GarronAnderson/InsideMyHive-V2/readme.md

# STM32 Beehive Monitor

in active development

thanks to 
https://github.com/Reetabass/STM32-HAL-SX1276-LoRa 
for the LoRa libraries
and
https://github.com/libdriver/htu21d
for the htu21d driver
