GarronAnderson/InsideMyHive-V2/datasheets for PCB/st-link pinout.png

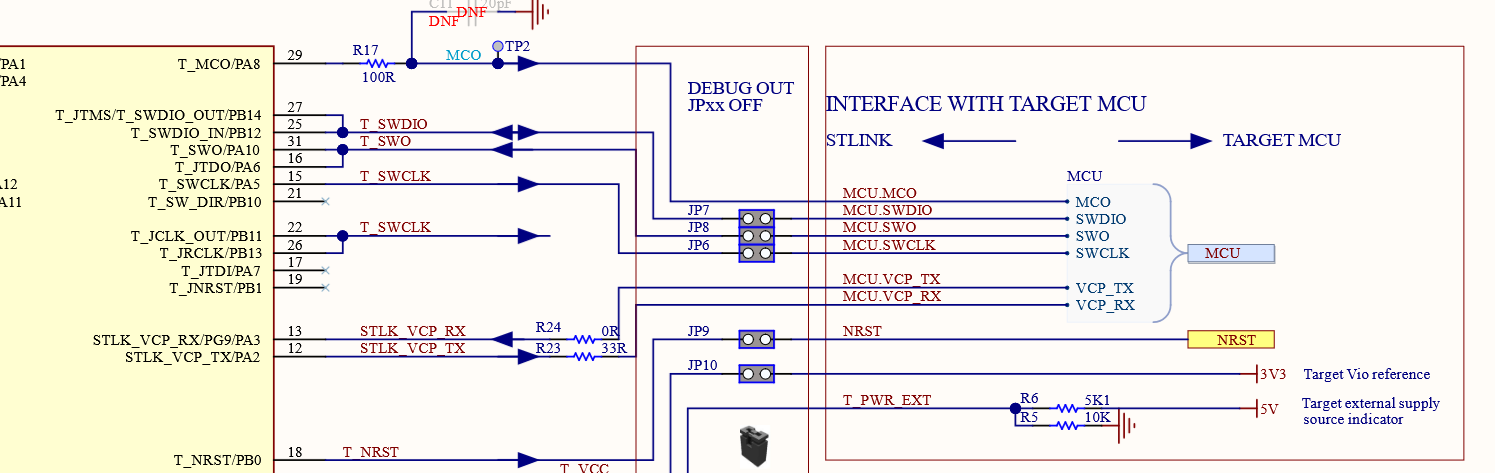
datasheets for PCB/st-link pinout.png
