GarronAnderson/InsideMyHive-V2/monitor pcb/monitor pcb.csv

# | Reference | Qty | Value | Footprint | DNP
1 | AE1 | 1 | Antenna
2 | C1, C2, C3, C5, C7 | 5 | 100nF | Capacitor_SMD:C_0603_1608Metric
3 | C4 | 1 | 10uF | Capacitor_SMD:C_0805_2012Metric
4 | C6 | 1 | 1uF | Capacitor_SMD:C_0603_1608Metric
5 | C8, C9 | 2 | 8.2, 10, 12 pF | Capacitor_SMD:C_0603_1608Metric
6 | C10, C11 | 2 | 1uF
7 | C12, C14, C15 | 3 | 0.1uF
8 | C13 | 1 | 330pF
9 | C16, C19, C20, C21, C23, C25, C26 | 7 | 100nF
10 | C17 | 1 | 22uF
11 | C18, C22, C24 | 3 | 10uF
12 | FB1 | 1 | FerriteBead_Small
13 | J1 | 1 | Conn_02x03_Counter_Clockwise
14 | J2 | 1 | TO LOAD CELL
15 | J3 | 1 | Tipping Bucket Rain Gauge
16 | J4 | 1 | on weather head
17 | J5 | 1 | from weather head
18 | J6 | 1 | in hive sensor
19 | J7 | 1 | from hive sensor
20 | J8 | 1 | 1S LiFePO4 (protected)
21 | J9 | 1 | pin header to TFT
22 | L1 | 1 | 2.2uH
23 | Q1 | 1 | DMP3125L-7
24 | R1, R2 | 2 | 47
25 | R3 | 1 | 36.5K
26 | R4 | 1 | 10k
27 | R5 | 1 | 100k
28 | R6, R7 | 2 | 4.7k
29 | R8, R9, R10, R11 | 4 | 33
30 | R13 | 1 | 470k
31 | SW1 | 1 | SW_Push
32 | U1 | 1 | STM32U031C8T6 | LQFP48_STM
33 | U2 | 1 | NAU7802SGI | SOI16_NAU7802SGI_NUV
34 | U3 | 1 | ~
35 | U4 | 1 | TPS63900 | Package_SON:WSON-10-1EP_2.5x2.5mm_P0.5mm_EP1.2x2mm_ThermalVias
36 | U5, U6 | 2 | HDC3022DEJR | DEJ0008A-C01-IPC_A
37 | U7 | 1 | BMP581 | QFN10_BMP581_BOS
38 | U8 | 1 | MB85RS1MT | Package_SO:SOIC-8_3.9x4.9mm_P1.27mm
39 | U9 | 1 | TPS22919DCKR | DCK0006A_N
40 | U10, U11 | 2 | TPD2E2U06DCKR | DCK0003A-IPC_A
41 | Y1 | 1 | Crystal | Crystal:Crystal_SMD_2012-2Pin_2.0x1.2mm
