GarronAnderson/InsideMyHive-V2/in hive sensor pcb/in_hive_sensor.kicad_pcb

## KiCad design in hive sensor pcb/in_hive_sensor.kicad_pcb (2026-10-23)

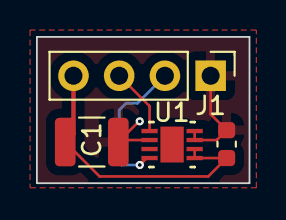
[picture p2: board in_hive_sensor.kicad_pcb from above]

Board: 2 copper layers, 11.8 x 8.1 mm, 4 parts (0 on the bottom side), 4 nets.

Parts:
C1: 10uF; C_1210_3225Metric
C2: 100nF; C_0603_1608Metric
J1: in hive sensor; PinHeader_1x04_P2.54mm_Vertical
U1: HDC3022DEJR; DEJ0008A-C01-IPC_A

Connections:
+3V3: C1.1, C2.2, J1.4, U1.5 (VDD), U1.6 (RESET_N)
GND: C1.2, C2.1, J1.1, U1.2 (ADDR), U1.7 (ADDR1), U1.8 (GND)
SCL: J1.2, U1.4 (SCL)
SDA: J1.3, U1.1 (SDA)
