GarronAnderson/InsideMyHive-V2/weather head pcb/weather_head.kicad_pcb

## KiCad design weather head pcb/weather_head.kicad_pcb (2026-10-23)

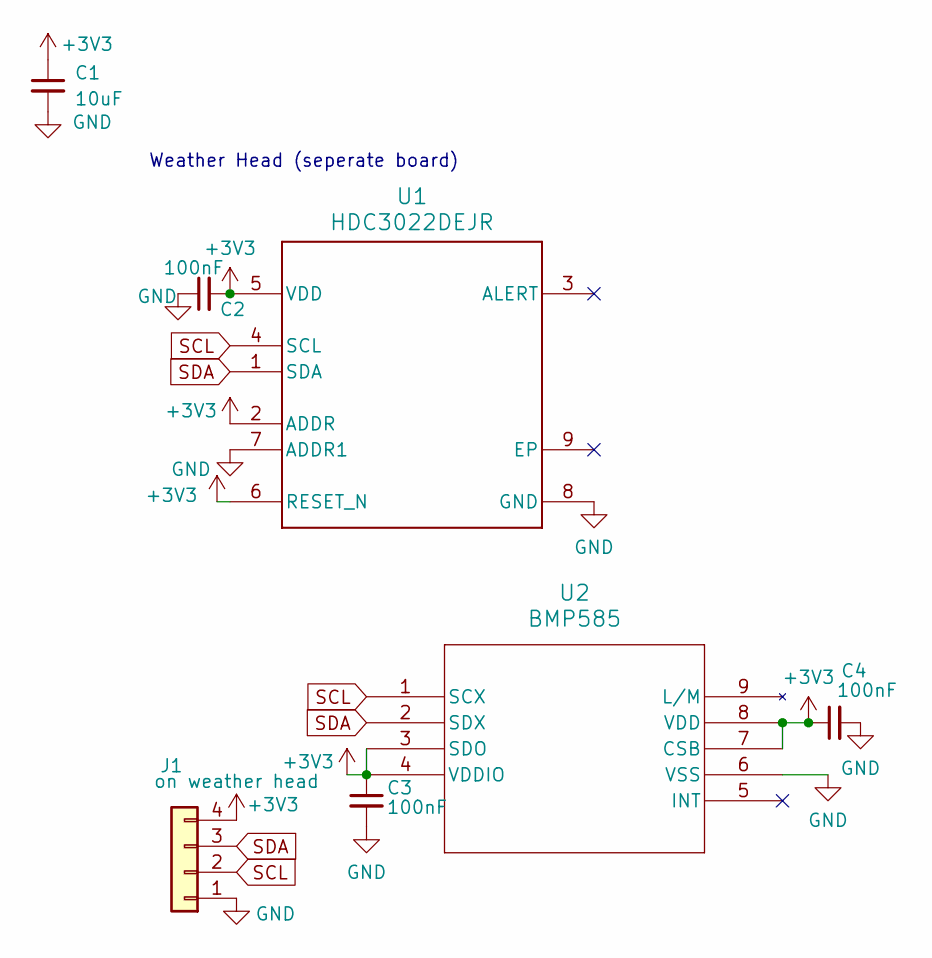
[picture p3: schematic weather_head.kicad_sch]

Parts:
C1: 10uF; C_1210_3225Metric
C2, C3, C4: 100nF; C_0603_1608Metric
J1: on weather head; PinHeader_1x04_P2.54mm_Vertical
U1: HDC3022DEJR; DEJ0008A-C01-IPC_A
U2: BMP585; LGA9_BMP585_BOS

Connections:
+3V3: C1.1, C2.2, C3.1, C4.1, J1.4, U1.2 (ADDR), U1.5 (VDD), U1.6 (RESET_N), U2.3 (SDO), U2.4 (VDDIO), U2.7 (CSB), U2.8 (VDD)
GND: C1.2, C2.1, C3.2, C4.2, J1.1, U1.7 (ADDR1), U1.8 (GND), U2.6 (VSS)
SCL: J1.2, U1.4 (SCL), U2.1 (SCX)
SDA: J1.3, U1.1 (SDA), U2.2 (SDX)

Notes on the sheet:
Weather Head (seperate board)

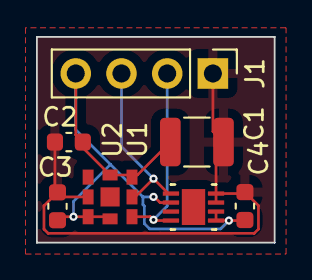
[picture p4: board weather_head.kicad_pcb from above]

Board: 2 copper layers, 13.2 x 11.4 mm, 7 parts (0 on the bottom side), 4 nets.
