GarronAnderson/InsideMyHive-V2/monitor pcb/monitor pcb.kicad_pcb

## KiCad design monitor pcb/monitor pcb.kicad_pcb (2026-10-23)

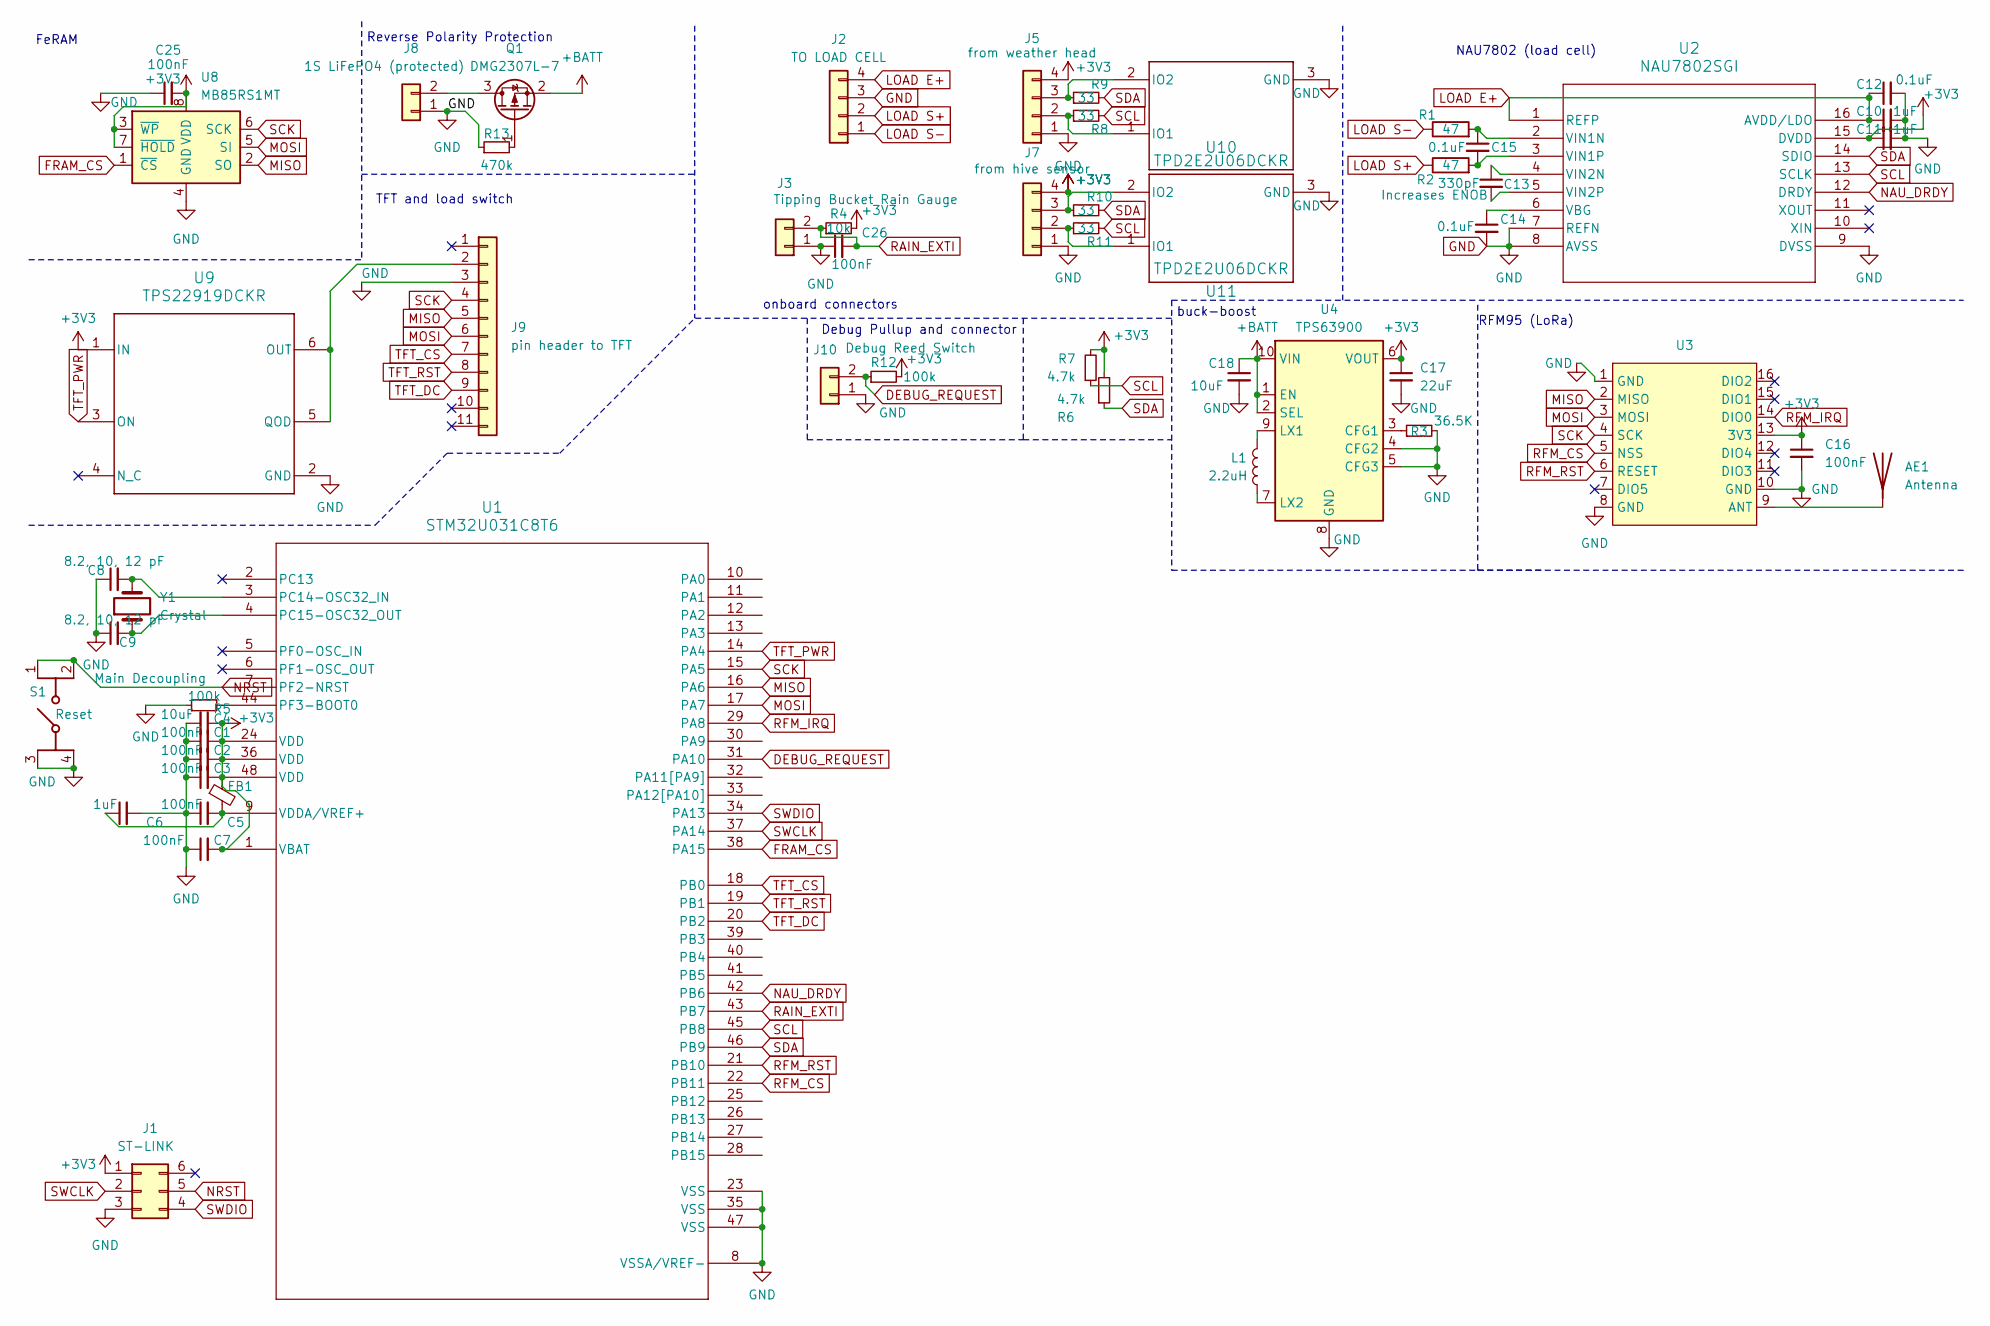
[picture p5: schematic monitor pcb.kicad_sch, Beehive Monitor PCB]

Parts:
AE1: Antenna; SMA_EDGELAUNCH
C1, C2, C3, C5, C7, C16, C25, C26: 100nF; C_0603_1608Metric
C4: 10uF; C_0805_2012Metric
C6: 1uF; C_0603_1608Metric
C8, C9: 8.2, 10, 12 pF; C_0402_1005Metric
C10, C11: 1uF; C_0805_2012Metric
C12, C14, C15: 0.1uF; C_0603_1608Metric
C13: 330pF; C_0402_1005Metric
C17: 22uF; C_1210_3225Metric
C18: 10uF; C_1210_3225Metric
FB1: FerriteBead_Small; L_0603_1608Metric
J1: Conn_02x03_Counter_Clockwise; PinHeader_2x03_P2.54mm_Vertical
J2: TO LOAD CELL; TerminalBlock_Phoenix_PT-1,5-4-3.5-H_1x04_P3.50mm_Horizontal
J3: Tipping Bucket Rain Gauge; TerminalBlock_Phoenix_PT-1,5-2-3.5-H_1x02_P3.50mm_Horizontal
J5: from weather head; TerminalBlock_Phoenix_PT-1,5-4-3.5-H_1x04_P3.50mm_Horizontal
J7: from hive sensor; TerminalBlock_Phoenix_PT-1,5-4-3.5-H_1x04_P3.50mm_Horizontal
J8: 1S LiFePO4 (protected); JST_PH_S2B-PH-K_1x02_P2.00mm_Horizontal
J9: pin header to TFT; PinHeader_1x11_P2.54mm_Vertical
J10: Debug Reed Switch; PinHeader_1x02_P2.54mm_Vertical
L1: 2.2uH; SRN3015TA2R2M
Q1: DMG2307L-7; SOT-23-3
R1, R2: 47; R_0603_1608Metric
R3: 36.5K; R_0603_1608Metric
R4: 10k; R_0603_1608Metric
R5, R12: 100k; R_0603_1608Metric
R6, R7: 4.7k; R_0603_1608Metric
R8, R9, R10, R11: 33; R_0603_1608Metric
R13: 470k; R_0603_1608Metric
S1: PTS647SN38SMTR2_LFS; PTS647SM38SMTR2LFS; Manufacturer_Part_Number PTS647SN38SMTR2 LFS
U1: STM32U031C8T6; LQFP-48_7x7mm_P0.5mm
U2: NAU7802SGI; SOIC-16_3.9x9.9mm_P1.27mm
U3: RFM95W
U4: TPS63900; WSON-10-1EP_2.5x2.5mm_P0.5mm_EP1.2x2mm_ThermalVias
U8: MB85RS1MT; SOIC-8_3.9x4.9mm_P1.27mm
U9: TPS22919DCKR; SOT-363_SC-70-6
U10, U11: TPD2E2U06DCKR; SOT-323_SC-70
Y1: Crystal; Crystal_SMD_2012-2Pin_2.0x1.2mm

Connections:
+3V3: C1.2, C2.2, C3.2, C4.1, C7.2, C11.1, C16.1, C17.1, C25.2, FB1.1, J1.1, J5.4, J7.4, R4.2, R6.2, R7.2, R12.2, U1.1 (VBAT), U1.24 (VDD), U1.36 (VDD), U1.48 (VDD), U2.15 (DVDD), U3.13 (3V3), U4.6 (VOUT), U8.3 (~WP), U8.7 (~HOLD), U8.8 (VDD), U9.1 (IN)
+BATT: C18.1, Q1.2 (S), U4.1 (EN), U4.2 (SEL), U4.10 (VIN)
DEBUG_REQUEST: J10.2, R12.1, U1.31 (PA10)
FRAM_CS: U1.38 (PA15), U8.1 (~CS)
GND: AE1.GND@1, AE1.GND@2, AE1.GND@3, AE1.GND@4, C1.1, C2.1, C3.1, C4.2, C5.1, C6.2, C7.1, C8.1, C9.1, C10.2, C11.2, C12.2, C14.2, C16.2, C17.2, C18.2, C25.1, C26.1, J1.3, J2.3, J3.1, J5.1, J7.1, J8.1, J9.3, J10.1, R3.2, R5.1, R13.1, S1.3 (COM_1), S1.4 (COM_2), U1.8 (VSSA/VREF-), U1.23 (VSS), U1.35 (VSS), U1.47 (VSS), U2.7 (REFN), U2.8 (AVSS), U2.9 (DVSS), U3.1 (GND), U3.8 (GND), U3.10 (GND), U4.4 (CFG2), U4.5 (CFG3), U4.8 (GND), U4.11 (GND), U8.4 (GND), U9.2 (GND), U10.3 (GND), U11.3 (GND)
LOAD E+: C10.1, C12.1, J2.4, U2.1 (REFP), U2.16 (AVDD/LDO)
LOAD S+: J2.2, R2.1
LOAD S-: J2.1, R1.1
MISO: J9.5, U1.16 (PA6), U3.2 (MISO), U8.2 (SO)
MOSI: J9.6, U1.17 (PA7), U3.3 (MOSI), U8.5 (SI)
NAU_DRDY: U1.42 (PB6), U2.12 (DRDY)
NRST: J1.5, S1.1 (NO_1), S1.2 (NO_2), U1.7 (PF2-NRST)
unnamed: AE1.1, AE1.P, U3.9 (ANT)
unnamed: J5.2, R8.1, U10.1 (IO1)
unnamed: J5.3, R9.1, U10.2 (IO2)
unnamed: J7.2, R11.1, U11.1 (IO1)
unnamed: J7.3, R10.1, U11.2 (IO2)
unnamed: J8.2, Q1.3 (D)
unnamed: J9.2, U9.5 (QOD), U9.6 (OUT)
unnamed: Q1.1 (G), R13.2
unnamed: C8.2, U1.3 (PC14-OSC32_IN), Y1.2
unnamed: C9.2, U1.4 (PC15-OSC32_OUT), Y1.1
unnamed: R5.2, U1.44 (PF3-BOOT0)
unnamed: C5.2, C6.1, FB1.2, U1.9 (VDDA/VREF+)
unnamed: C14.1, U2.6 (VBG)
unnamed: C15.1, R1.2, U2.2 (VIN1N)
unnamed: C15.2, R2.2, U2.3 (VIN1P)
unnamed: C13.1, U2.4 (VIN2N)
unnamed: C13.2, U2.5 (VIN2P)
unnamed: R3.1, U4.3 (CFG1)
unnamed: L1.2, U4.9 (LX1)
unnamed: L1.1, U4.7 (LX2)
RAIN_EXTI: C26.2, J3.2, R4.1, U1.43 (PB7)
RFM_CS: U1.22 (PB11), U3.5 (NSS)
RFM_IRQ: U1.29 (PA8), U3.14 (DIO0)
RFM_RST: U1.21 (PB10), U3.6 (RESET)
SCK: J9.4, U1.15 (PA5), U3.4 (SCK), U8.6 (SCK)
SCL: R7.1, R8.2, R11.2, U1.45 (PB8), U2.13 (SCLK)
SDA: R6.1, R9.2, R10.2, U1.46 (PB9), U2.14 (SDIO)
SWCLK: J1.2, U1.37 (PA14)
SWDIO: J1.4, U1.34 (PA13)
TFT_CS: J9.7, U1.18 (PB0)
TFT_DC: J9.9, U1.20 (PB2)
TFT_PWR: U1.14 (PA4), U9.3 (ON)
TFT_RST: J9.8, U1.19 (PB1)

Notes on the sheet:
Debug Pullup and connector
onboard connectors
FeRAM
RFM95 (LoRa)
Reverse Polarity Protection
buck-boost
NAU7802 (load cell)
TFT and load switch

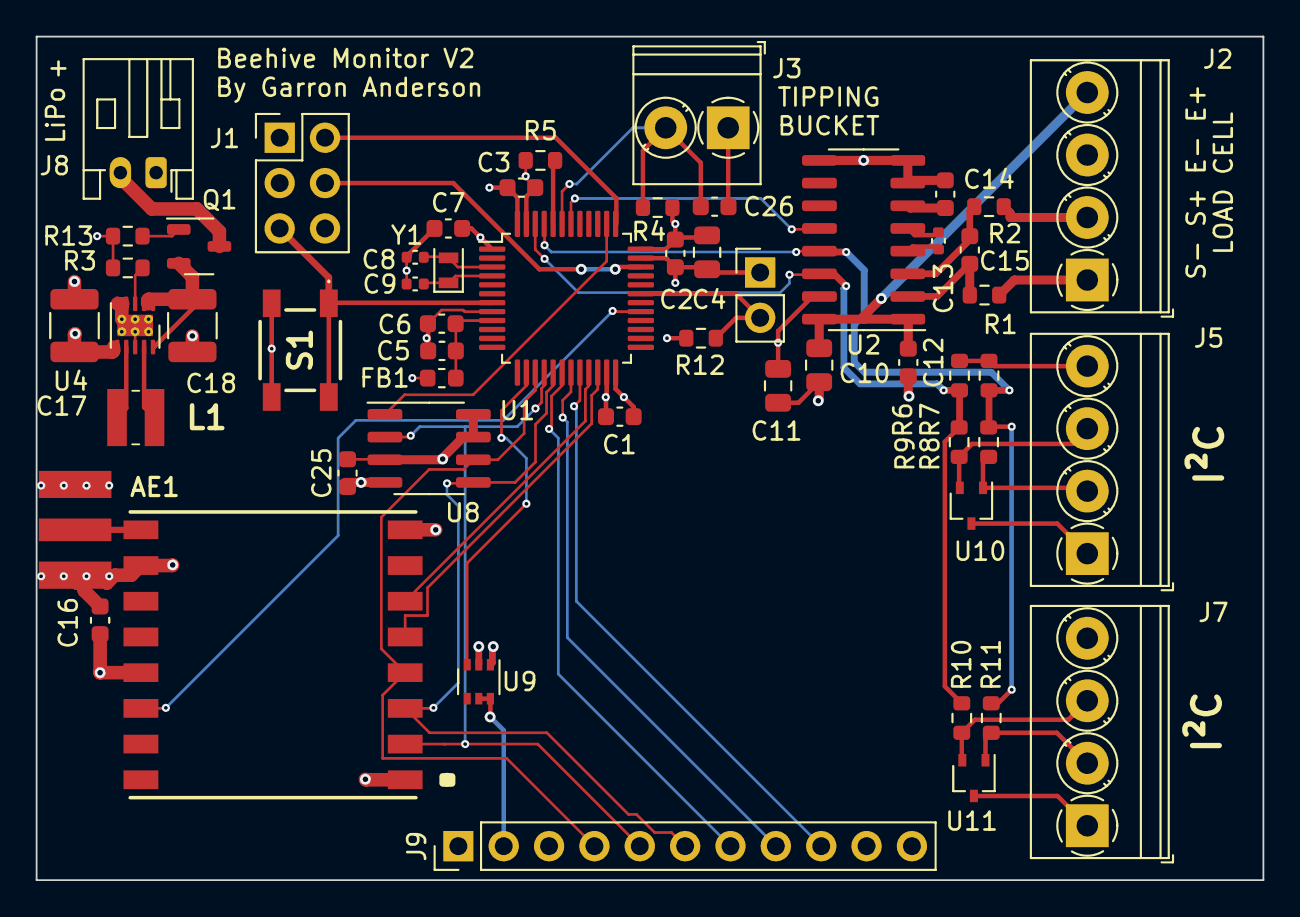
[picture p6: board monitor pcb.kicad_pcb from above]

Board: 4 copper layers, 68.7 x 47.2 mm, 55 parts (0 on the bottom side), 45 nets.
