GarronAnderson/InsideMyHive-V2/pcb version/pcb version.ioc

Mcu.UserName=STM32U031C8Tx
PA10.GPIO_Label=DEBUG_REQUEST
PA10.Signal=GPXTI10
PA15.GPIO_Label=FRAM_CS
PA15.Signal=GPIO_Output
PA4.GPIO_Label=TFT_PWR
PA4.Signal=GPIO_Output
PA5.Signal=SPI1_SCK
PA6.Signal=SPI1_MISO
PA7.Signal=SPI1_MOSI
PA8.GPIO_Label=RFM_IRQ
PA8.Signal=GPXTI8
PB0.GPIO_Label=TFT_CS
PB0.Signal=GPIO_Output
PB1.GPIO_Label=TFT_RST
PB1.Signal=GPIO_Output
PB10.GPIO_Label=RFM_RST
PB10.Signal=GPIO_Output
PB11.GPIO_Label=RFM_CS
PB11.Signal=GPIO_Output
PB2.GPIO_Label=TFT_DC
PB2.Signal=GPIO_Output
PB6.GPIO_Label=NAU_DRDY
PB6.Signal=GPXTI6
PB7.GPIO_Label=RAIN_EXTI
PB7.Signal=GPXTI7
PB8.Signal=I2C1_SCL
PB9.Signal=I2C1_SDA
PC14-OSC32_IN.Signal=RCC_OSC32_IN
PC15-OSC32_OUT.Signal=RCC_OSC32_OUT
