GarronAnderson/InsideMyHive-V2/STM32Monitor/Core/Src/driver_htu21d_interface_template.c

/**
 * Copyright (c) 2015 - present LibDriver All rights reserved
 * 
 * The MIT License (MIT)
 *
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
 * @file      driver_htu21d_interface_template.c
 * @brief     driver htu21d interface template source file
 * @version   1.0.0
 * @author    Shifeng Li
 * @date      2022-10-31
 *
 * <h3>history</h3>
 * <table>
 * <tr><th>Date        <th>Version  <th>Author      <th>Description
 * <tr><td>2022/10/31  <td>1.0      <td>Shifeng Li  <td>first upload
 * </table>
 */

#include "driver_htu21d_interface.h"
#include "main.h"

extern I2C_HandleTypeDef hi2c1;

/**
 * @brief  interface iic bus init
 * @return status code
 *         - 0 success
 *         - 1 iic init failed
 * @note   none
 */
uint8_t htu21d_interface_iic_init(void)
{
    return 0;
}

/**
 * @brief  interface iic bus deinit
 * @return status code
 *         - 0 success
 *         - 1 iic deinit failed
 * @note   none
 */
uint8_t htu21d_interface_iic_deinit(void)
{
    return 0;
}

/**
 * @brief     interface iic bus write command
 * @param[in] addr iic device write address
 * @param[in] *buf pointer to a data buffer
 * @param[in] len length of the data buffer
 * @return    status code
 *            - 0 success
 *            - 1 write failed
 * @note      none
 */
uint8_t htu21d_interface_iic_write_cmd(uint8_t addr, uint8_t *buf, uint16_t len)
{
    if (HAL_I2C_Master_Transmit(&hi2c1, addr, buf, len, 100) == HAL_OK)
    {
        return 0;
    }

    return 1;
}

/**
 * @brief      interface iic bus read command
 * @param[in]  addr iic device write address
 * @param[out] *buf pointer to a data buffer
 * @param[in]  len length of the data buffer
 * @return     status code
 *             - 0 success
 *             - 1 read failed
 * @note       none
 */
uint8_t htu21d_interface_iic_read_cmd(uint8_t addr, uint8_t *buf, uint16_t len)
{
    if (HAL_I2C_Master_Receive(&hi2c1, addr, buf, len, 100) == HAL_OK)
    {
        return 0;
    }

    return 1;
}

/**
 * @brief     interface iic bus write
 * @param[in] addr iic device write address
 * @param[in] reg iic register address
 * @param[in] *buf pointer to a data buffer
 * @param[in] len length of the data buffer
 * @return    status code
 *            - 0 success
 *            - 1 write failed
 * @note      none
 */
uint8_t htu21d_interface_iic_write(uint8_t addr,
                                   uint8_t reg,
                                   uint8_t *buf,
                                   uint16_t len)
{
    HAL_StatusTypeDef status;

    if (len == 0)
    {
        status = HAL_I2C_Master_Transmit(&hi2c1, addr, &reg, 1, 100);
    }
    else
    {
        status = HAL_I2C_Mem_Write(&hi2c1,
                                   addr,
                                   reg,
                                   I2C_MEMADD_SIZE_8BIT,
                                   buf,
                                   len,
                                   100);
    }

    return (status == HAL_OK) ? 0 : 1;
}

/**
 * @brief      interface iic bus read
 * @param[in]  addr iic device write address
 * @param[in]  reg iic register address
 * @param[out] *buf pointer to a data buffer
 * @param[in]  len length of the data buffer
 * @return     status code
 *             - 0 success
 *             - 1 read failed
 * @note       none
 */
uint8_t htu21d_interface_iic_read(uint8_t addr, uint8_t reg, uint8_t *buf, uint16_t len)
{
    if (HAL_I2C_Mem_Read(&hi2c1,
                         addr,
                         reg,
                         I2C_MEMADD_SIZE_8BIT,
                         buf,
                         len,
                         100) == HAL_OK)
    {
        return 0;
    }

    return 1;
}

/**
 * @brief      interface iic bus read with scl clock
 * @param[in]  addr iic device write address
 * @param[in]  reg iic register address
 * @param[out] *buf pointer to a data buffer
 * @param[in]  len length of the data buffer
 * @return     status code
 *             - 0 success
 *             - 1 read failed
 * @note       none
 */
uint8_t htu21d_interface_iic_read_with_scl(uint8_t addr, uint8_t reg, uint8_t *buf, uint16_t len)
{
	return htu21d_interface_iic_read(addr, reg, buf, len);
}

/**
 * @brief     interface delay ms
 * @param[in] ms time
 * @note      none
 */
void htu21d_interface_delay_ms(uint32_t ms)
{
	HAL_Delay(ms);
}

/**
 * @brief     interface print format data
 * @param[in] fmt format data
 * @note      none
 */
void htu21d_interface_debug_print(const char *const fmt, ...)
{
    
}
