GarronAnderson/InsideMyHive-V2/pcb version/Core/Inc/main.h

#define TFT_PWR_Pin GPIO_PIN_4
#define TFT_PWR_GPIO_Port GPIOA
#define TFT_CS_Pin GPIO_PIN_0
#define TFT_CS_GPIO_Port GPIOB
#define TFT_RST_Pin GPIO_PIN_1
#define TFT_RST_GPIO_Port GPIOB
#define TFT_DC_Pin GPIO_PIN_2
#define TFT_DC_GPIO_Port GPIOB
#define RFM_RST_Pin GPIO_PIN_10
#define RFM_RST_GPIO_Port GPIOB
#define RFM_CS_Pin GPIO_PIN_11
#define RFM_CS_GPIO_Port GPIOB
#define RFM_IRQ_Pin GPIO_PIN_8
#define RFM_IRQ_GPIO_Port GPIOA
#define RFM_IRQ_EXTI_IRQn EXTI4_15_IRQn
#define DEBUG_REQUEST_Pin GPIO_PIN_10
#define DEBUG_REQUEST_GPIO_Port GPIOA
#define DEBUG_REQUEST_EXTI_IRQn EXTI4_15_IRQn
#define FRAM_CS_Pin GPIO_PIN_15
#define FRAM_CS_GPIO_Port GPIOA
#define NAU_DRDY_Pin GPIO_PIN_6
#define NAU_DRDY_GPIO_Port GPIOB
#define NAU_DRDY_EXTI_IRQn EXTI4_15_IRQn
#define RAIN_EXTI_Pin GPIO_PIN_7
#define RAIN_EXTI_GPIO_Port GPIOB
#define RAIN_EXTI_EXTI_IRQn EXTI4_15_IRQn
