GarronAnderson/InsideMyHive-V2/pcb version/Core/Inc/power.h

/*
 * power.h
 *
 *  Created on: Sep 24, 2026
 *      Author: mfdal
 */

#ifndef INC_POWER_H_
#define INC_POWER_H_

void PowerUp(void);
void EnterSleep(void);

void PowerOnDisplay(void);
void PowerOffDisplay(void);

#endif /* INC_POWER_H_ */
