GarronAnderson/InsideMyHive-V2/(commit log)

2026-09-14 add .gitignore, enable SPI
2026-09-15 add st7735 display
    note: AI (ChatGPT) was used to assist with porting the st7735 display and writing a graphics driver
2026-10-04 add lora and FRAM queue
    LoRa driver works.
    FRAM FIFO queue that holds data. Push, peek, and pop support.
    Moved transmitting a packet into its own file. hive_packet.h also contains a def for the packed struct that holds the packet.
    Debug can be requested through a switch. This powers up the LCD and shows what's happening.
    power.c powers up and down peripherals
2026-10-07 make a schematic
    make a schematic! temp/humid and baro sensors still to be picked.
2026-10-23 gerbers to fab
    these are the gerbers sent to fab.
    We'll see how many mistakes I made in them later.
2026-10-24 Backup PCBs
2026-11-02 bring up to date for PCB
    create a ibom for assembly
    change ioc settings to compile for MCU on board
    move files for mcu on board to new folder
